dzmitry-murauyou/schem/pcb_top_overlay.pdf

ESP32 DevKit V1 (USB up) EN VP VN IO³⁴ IO³⁵ IO³² IO³³ IO²⁵ IO²⁶ IO²⁷ IO¹⁴ IO¹² IO¹³ GND VIN

IO23 IO22 TX0 RX0 IO21 IO19 IO18 IO5 TX2 RX2 IO4 IO2 IO15 GND 3V3

## J_BTN1

GND SIG

## J_BTN2

GND SIG

## J_BTN3

GND SIG

## J_BTN4

GND SIG

## LED1

K A
R1
| 2

1

## LED2

K A
R2
| 2

1

## LED3

K A
R3
| 2

1

## J_RTC

VCC GND CLK DAT RST

## J_SENSOR

VCC GND SCL SDA

## J_LCD

GND VCC SDA SCL

## J_PWR

+5V GND

BZ1
+ | -

Component side, 1:1
