dzmitry-murauyou/schem/lut_bottom_mirrored.png

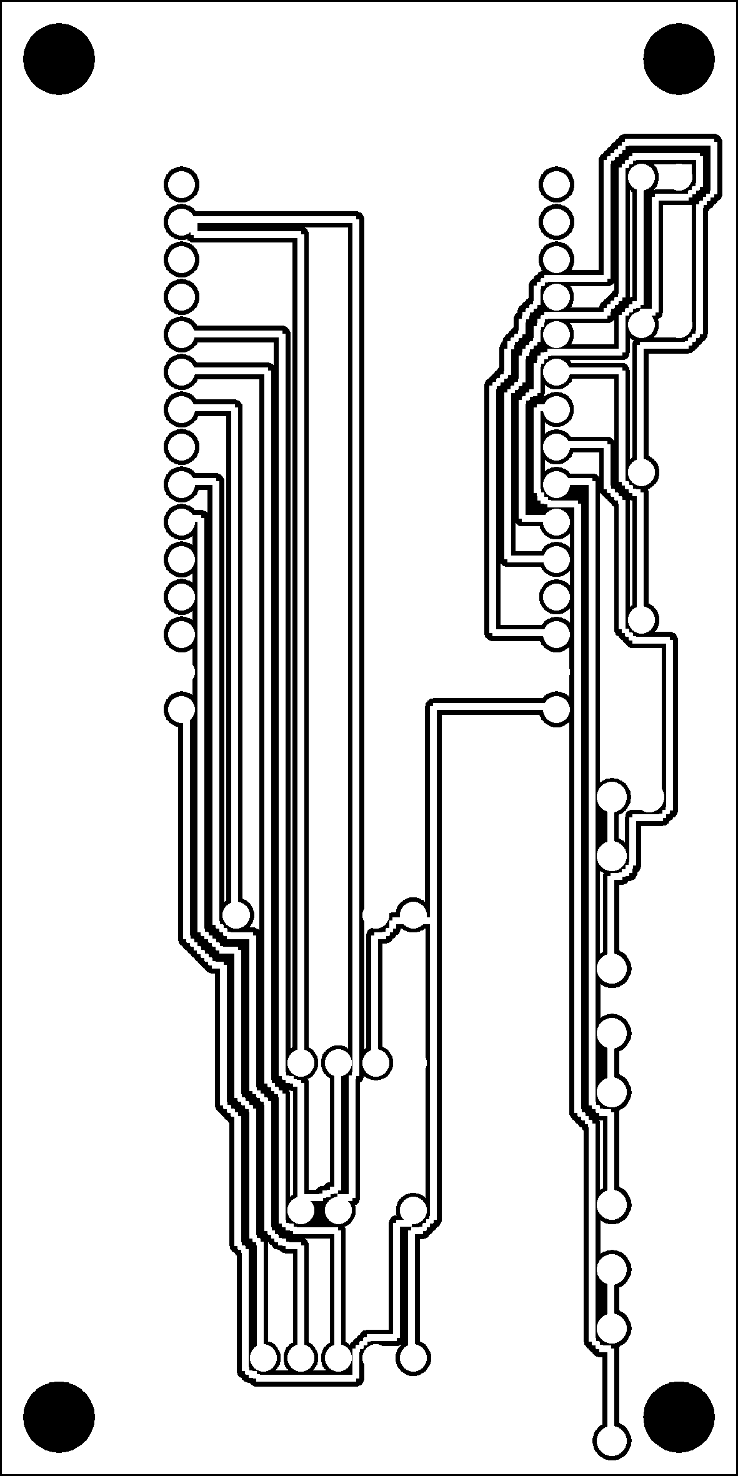
lut_bottom_mirrored.png
