dzmitry-murauyou/schem/preview.png

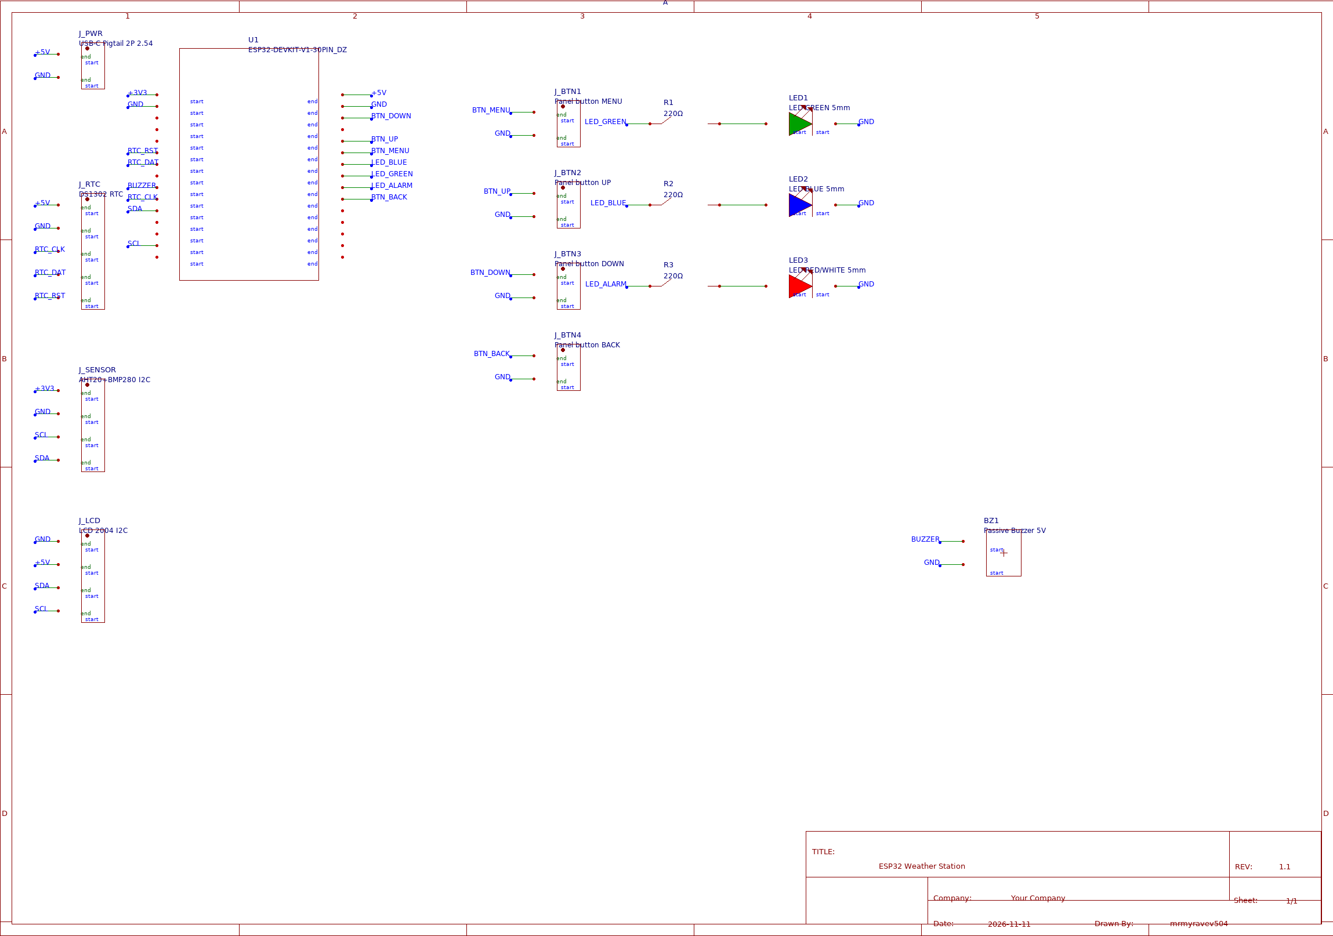
preview.png
