dzmitry-murauyou/schem/lut_bottom_mirrored.pdf

# ESP32 DevKit V1 (USB up)

## J_BTN1

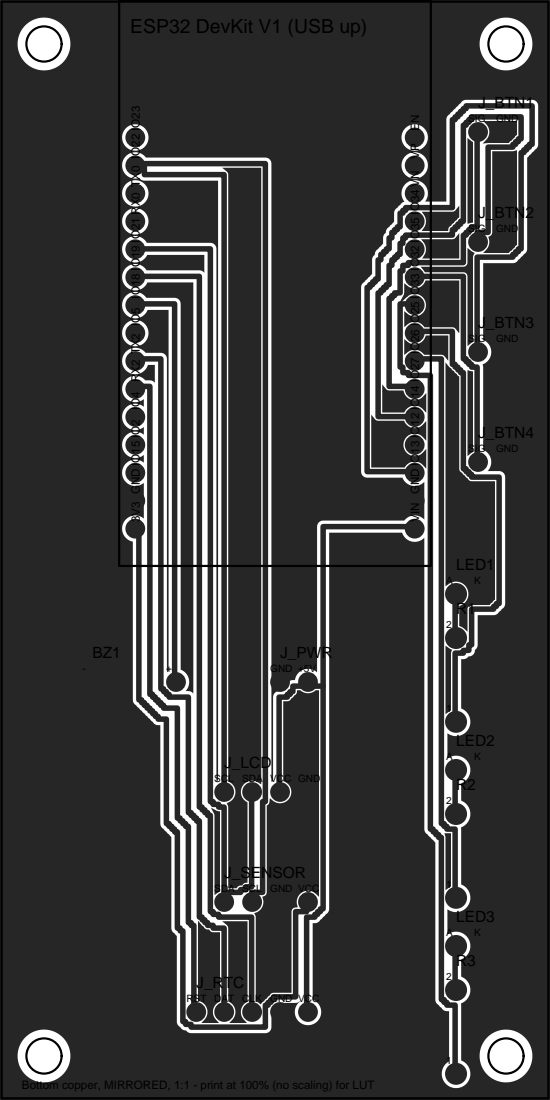
[picture p3: page 1]
IO23 IO22 TX0 RX0 IO21 IO19 IO18 IO5 TX2 RX2 IO4 IO2 IO15 GND 3V3; SIG GND; J_BTN2; SIG; GND; J_BTN3; J_BTN4; LED1; LED2; LED3; J_SENSOR; SDA SCL; GND VCC; J_LCD; SCL SDA; VCC GND; J_PWR; GND +5V

EN VP VN IO34 IO35 IO32 IO33 IO25 IO26 IO27 IO14 IO12 IO13 GND VIN

J_RTC
RST DAT CLK GND VCC

Bottom copper, MIRRORED, 1:1 - print at 100% (no scaling) for LUT
