dzmitry-murauyou/schem/(list of files, drawings)

Other design files:
SCH_ESP32_WeatherStation_2026-11-11.json
SCH_New-Project1_2026-11-11.json
