dzmitry-murauyou/schem/(commit log)

2026-11-11 Rebuild schematic to the agreed hardware spec
    The original sheet had no connectivity (one wire, three labels), four
    PCB-mount tact switches, three identical red LEDs, resistors designators
    U4/U5/U6 with a placeholder value, a 1.27mm power header, a 6.35mm RTC
    header, an SMD buzzer, no AHT20+BMP280 at all, and no 3.3V rail.
    Rebuilt as: J_PWR (2P 2.54mm USB-C pigtail), J_BTN1-4 (off-board panel
    buttons on GPIO 27/14/13/32), R1-R3 220R + green/blue/red LEDs on
    GPIO 25/26/33, BZ1 passive buzzer on GPIO 18, J_SENSOR AHT20+BMP280 on
    the 3.3V I2C bus, J_LCD 2004 I2C and J_RTC DS1302 on 5V.
    Adds a generator plus two self-checks: connectivity is re-derived from the
    drawn geometry and compared again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
    [SCH_ESP32_WeatherStation_2026-11-11.json, bom.csv]
2026-11-11 Add 50x100 mm single-sided PCB generator for LUT (toner transfer)
    Fits the ESP32 DevKit V1 (51.45 x 28.33 mm) along the 100 mm axis and
    routes all 18 signal nets as 0.5 mm traces with 0.3 mm clearance.
    Ground is a copper pour; the islands the traces cut it into are linked
    by 4 component-side jumpers, drawn on the overlay and listed in the
    report. Every net is verified to be a single piece of copper before the
    artwork is written.
    Outputs the mirrored 1:1 LUT PDF/PNG/SVG, a component overlay, Gerbers
    plus Excellon drill, and a DRC/connectivity report.
    [board_outline.gm1, bottom_copper.gbl, drill.drl]
